arsenal007/TRX/README.md

DIY HF Transceiver
	1) KiCAD PCBs:
		1.1 VFOs
		1.2 MAINBOARDs
		1.3 BPFs
		1.4 AMPs
	2)  VFO firmware
	3) measurements
