arsenal007/TRX/VFOs/UR3ILF_SI5351/cqham/firmware_si5351_28.02.17/README.txt

var1 = mechanical encoder 
var2 = mechanical 4 tact encoder
var3 = optical encoder
