arsenal007/TRX/VFOs/UR3ILF_SI5351/cqham/pcb synt ur3ilf(UPD)/README.RUS.docx

Сделал* две печатные платы синтезатора Андрея UR3ILF.

Спасибо Андрею за хорошую и простую конструкцию!!!

Печатные платы от авторской отличаются следующим:

0. Они универсальны! Хотите утюжьте или Китайчикам на Али заказывайте. Вторая сторона в случаи ЛУТ закрашивается, после травления зенкуется и устанавливаются необходимые перемычки (показаны связями).

1.Размерами. Мои платы чуть больше.

2.Убрал узел на LM358. На мой взгляд, его проще расположить на валкодере, да и в последнее время трудно стало найти мышку шариковую уже))). К синтезатору Вы сможете подключить любую «трещотку» 48 импульсов или оптический энкодер с открытым коллектором ( тогда конденсаторы 4700пф которые "сидят" на общий провод с 1й и 32 ноги atmega 168&328) устанавливать не нужно.

3.Добавил разъем (ISP бокового-углового исполнения) для удобного и быстрого подключения программатора usbasp через шлейф с которым он продается на Ali.

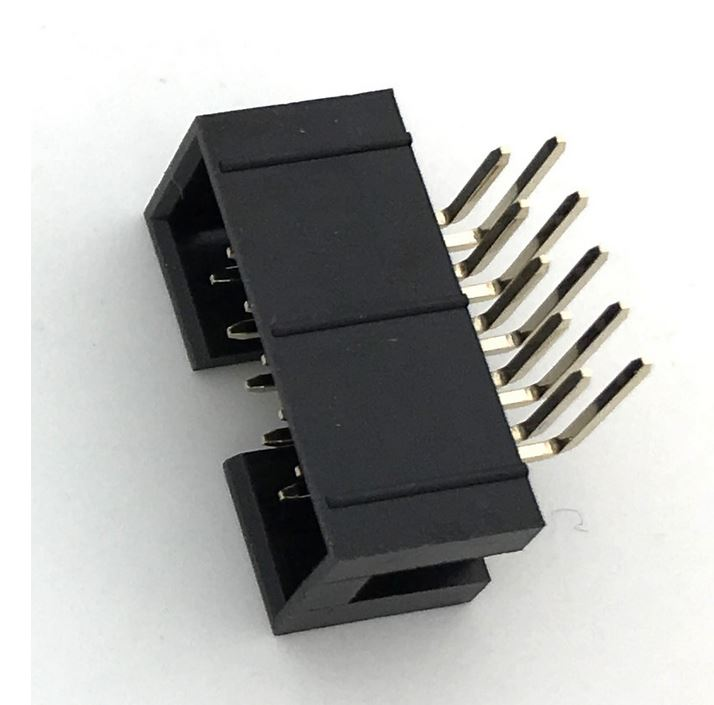
[picture p1: figure]

4. Добавил разъемы типа SMA (углового типа) для всех трех выходов CLK0,1,2 SI5351. Быть может нужен будет CLK2 кому либо.

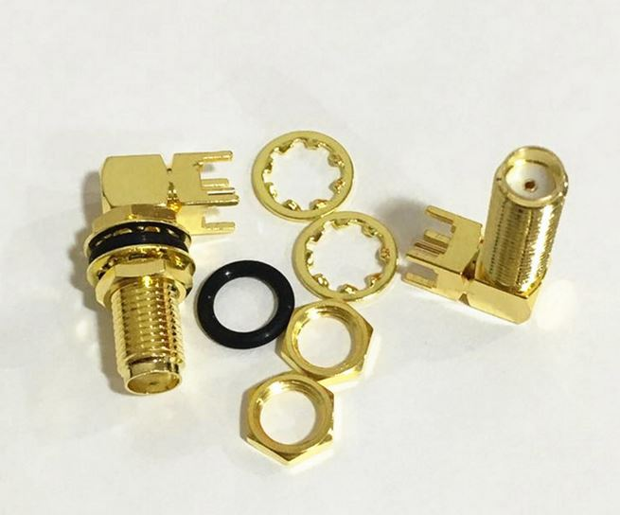
[picture p2: figure]

5. После выходов dds имеются площадки для установки smd индуктивностей и конденсаторов для фильтр пробок.

6. Разводка дисплея сделана под дешевый Китайский вариант с верхним однорядным расположением пинов.

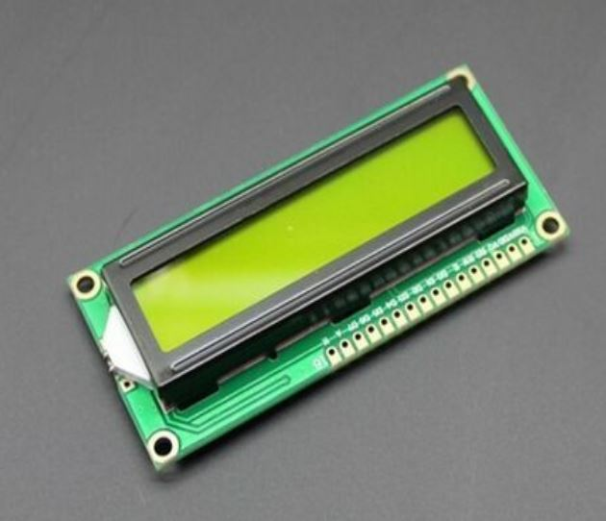
[picture p3: figure]

Детали

Резисторы и конденсаторы изпользуются в разных корпусах это 1206 и 0805.

Упор делался на 1206 так как с ними проще работать имея дрожащие руки и плохое зрение.

Все номиналы подписаны на плате и отображаются когда подводишь курсор к элементу.

В дисплей впаивается 16 штырьковая вилка PLS-16.

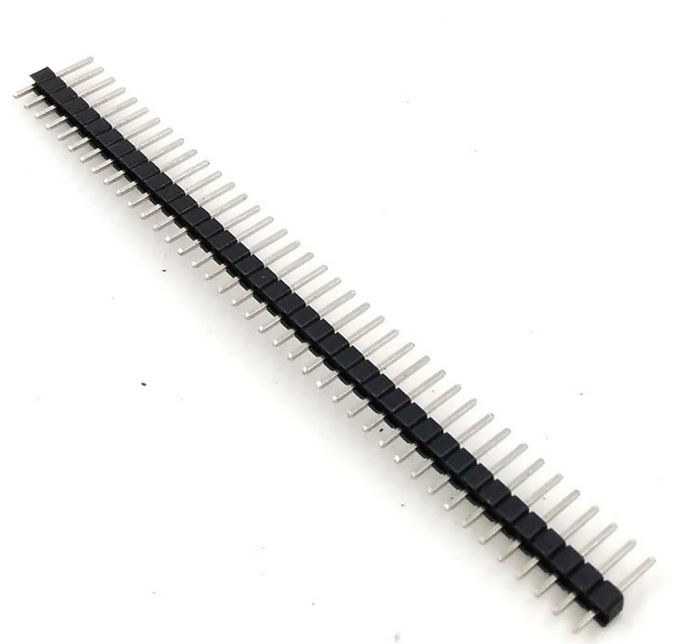
[picture p4: figure]

В плату впаивается для вилки гнездо PBS-16 .

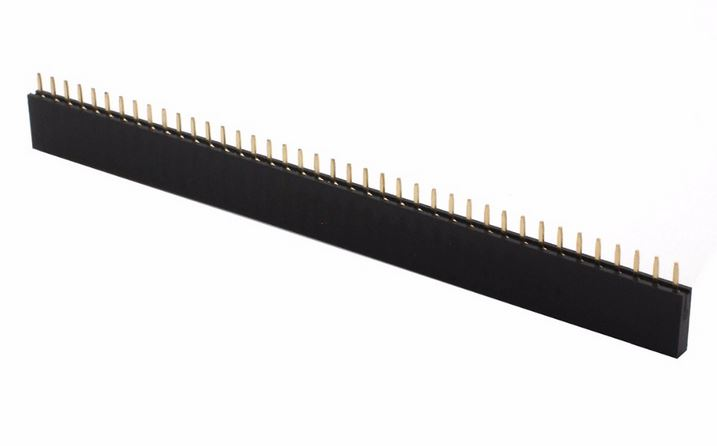
[picture p5: figure]

Дсплей крепится на 4 шт стойки латунные шестигранные, h = 10 мм, резьба под винт М3.

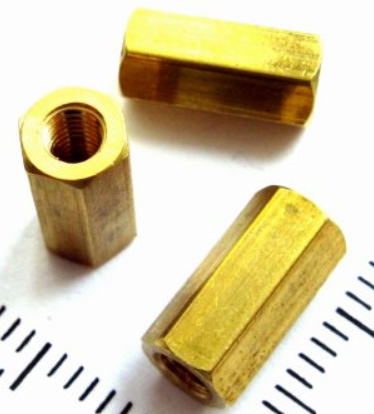
[picture p6: figure]

Разьем питания PLS 2 штырька. Можно сделать из любого разъема.

Все остальные штыревые разъемы углового типа PLS.

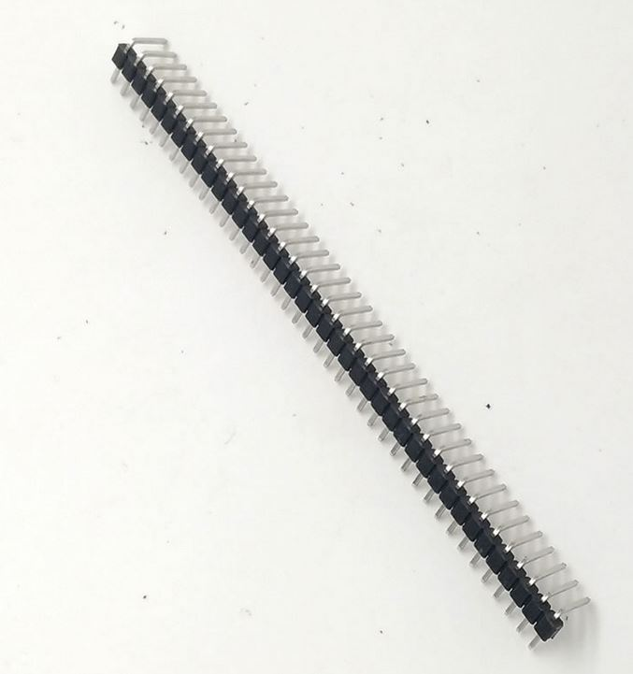
[picture p7: figure]

SMA используюся также углового типа (см рис выше).

В ахиве две печатных платы. Первая для более старшей конструкции ( прошивка пост 722 http://www.cqham.ru/forum/showthread.php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

Версия 2 печатка для конструкции http://ur3ilf.blogspot.ru/ более новой пост 740

http://www.cqham.ru/forum/showthread.php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

*-P.S эти печатки я «в железе» еще не проверял. Пожалуйста перед тем как повторять проверьте!!!
