arsenal007/TRX/MAINBOARDs/QER/QER.GIF

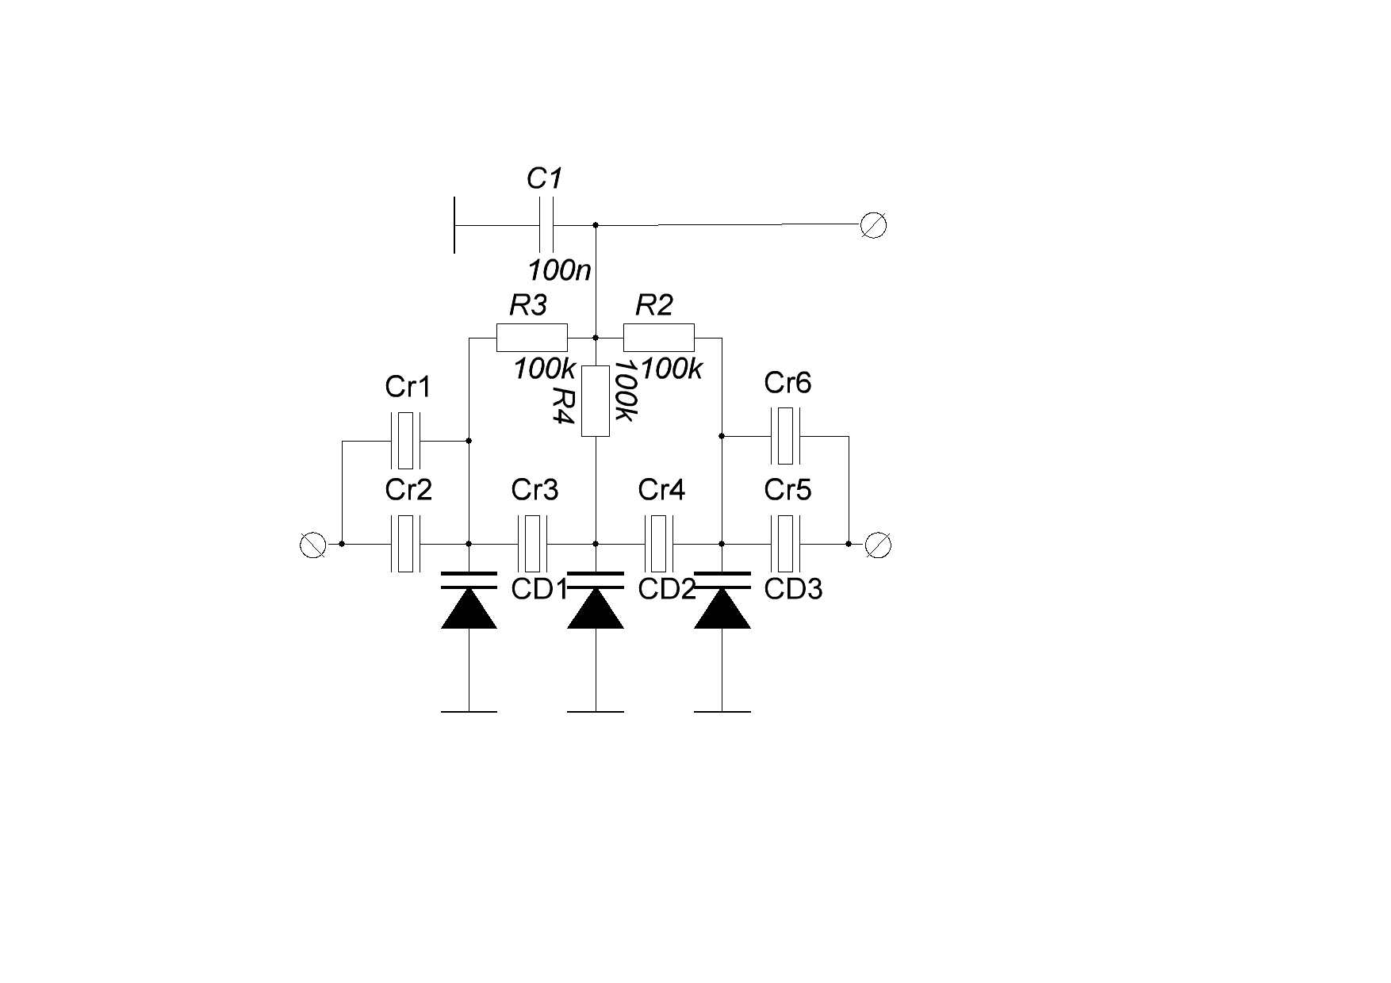
MAINBOARDs/QER/QER.GIF
