arsenal007/TRX/MAINBOARDs/QER/rst-a976.gif

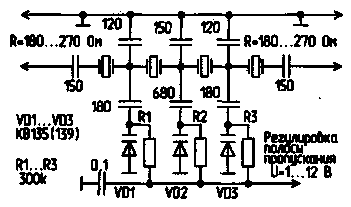
MAINBOARDs/QER/rst-a976.gif
