arsenal007/TRX/VFOs/UT5QBC/HF-EASY2-Schematic.png

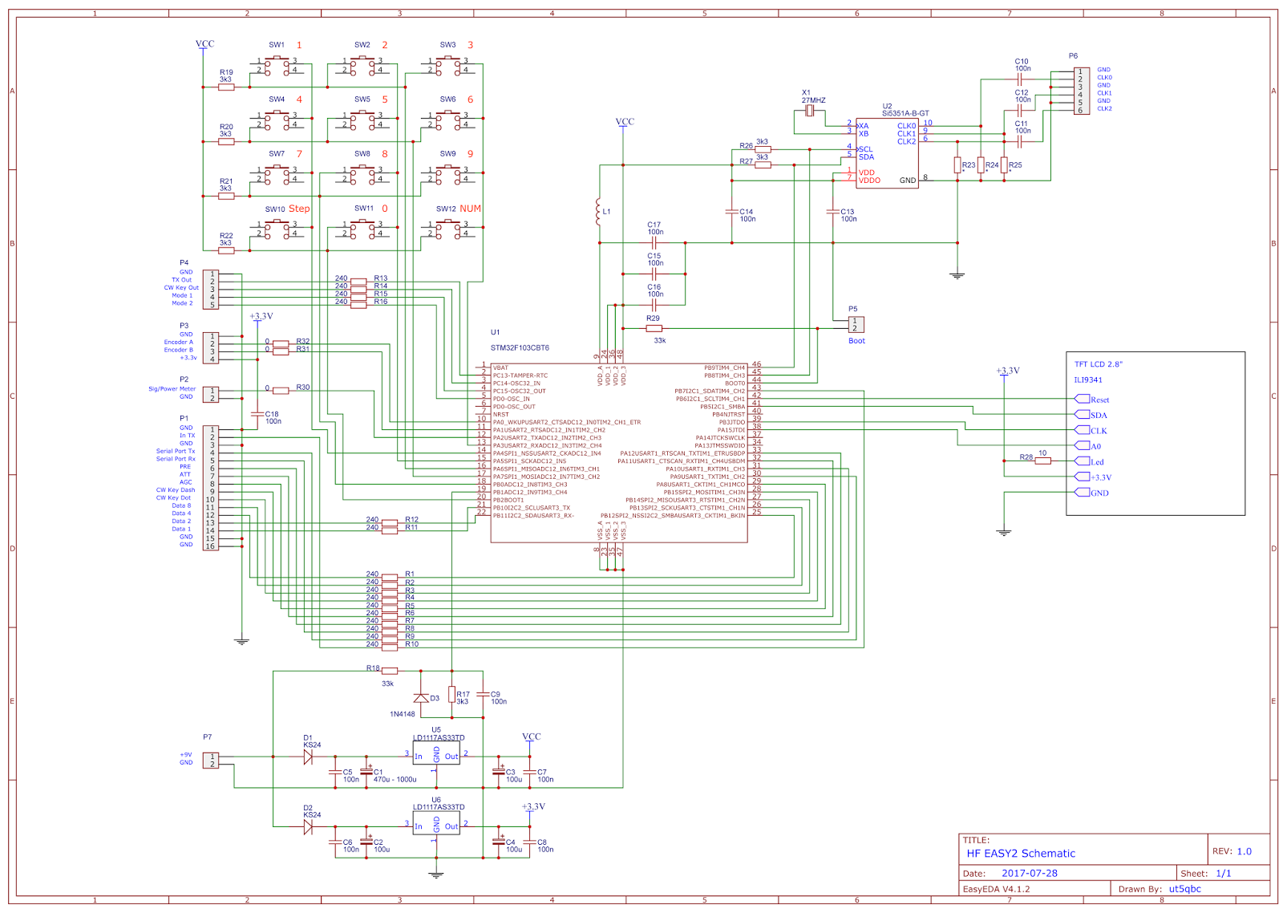
VFOs/UT5QBC/HF-EASY2-Schematic.png
