arsenal007/TRX/VFOs/UR3ILF_SI5351/KiCAD_PCB/UR3ILF.pdf

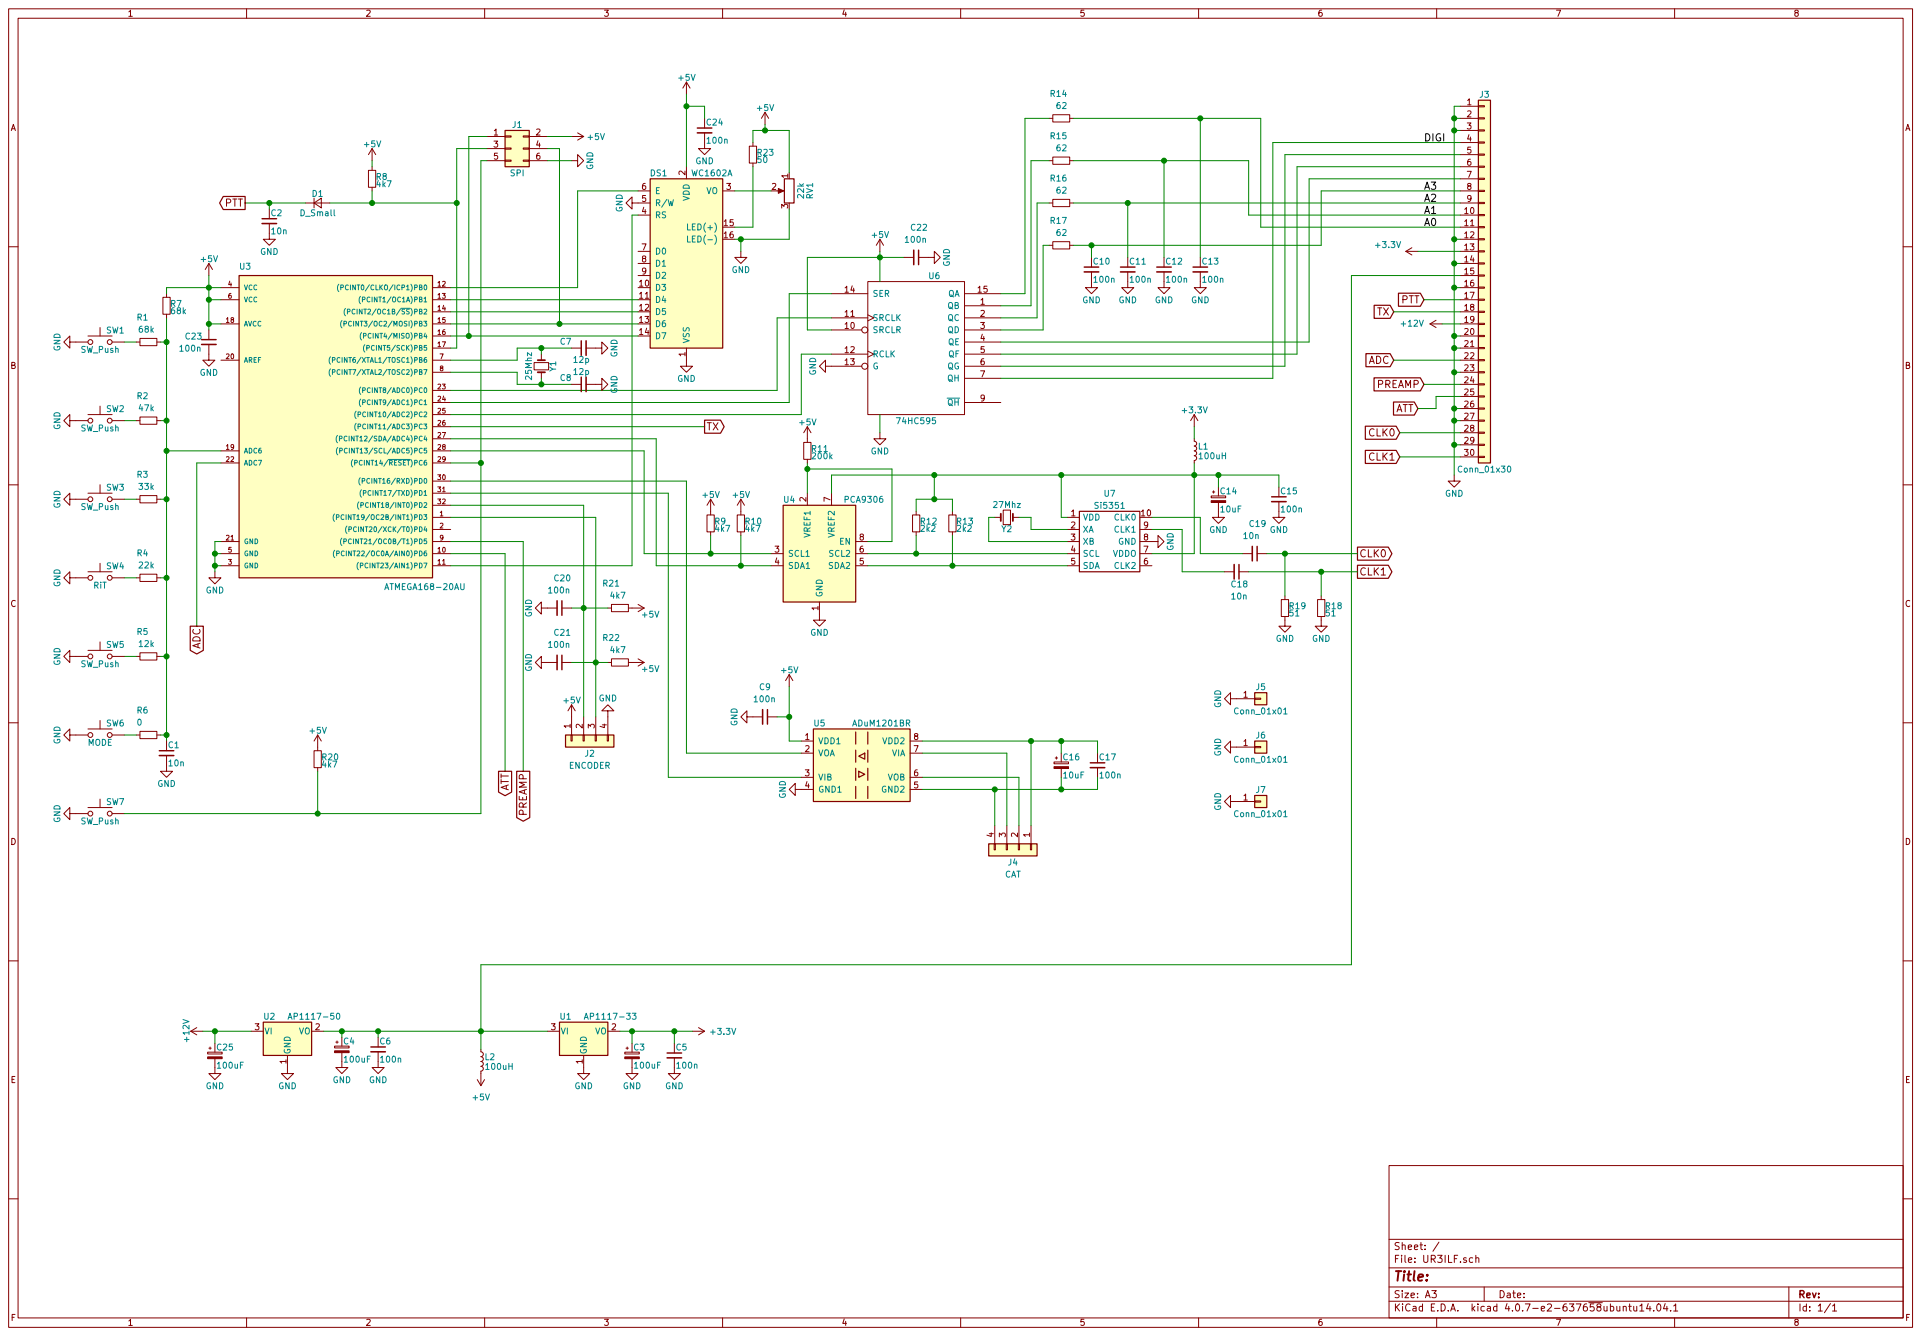
[picture p25: page 1]
