arsenal007/TRX/(list of files, drawings)

Other design files:
VFOs/UR3ILF_SI5351/cqham/pcb synt ur3ilf(UPD)/pcb synt ur3ilf ver1.lay6
VFOs/UR3ILF_SI5351/cqham/pcb synt ur3ilf(UPD)/pcb synt ur3ilf ver2.lay6
VFOs/UR3ILF_SI5351/cqham/schematics_splan/schematics.spl7
