arsenal007/TRX/MAINBOARDs/raisin/Raisin.kicad_pcb

## KiCad design MAINBOARDs/raisin/Raisin.kicad_pcb (2019-11-10)

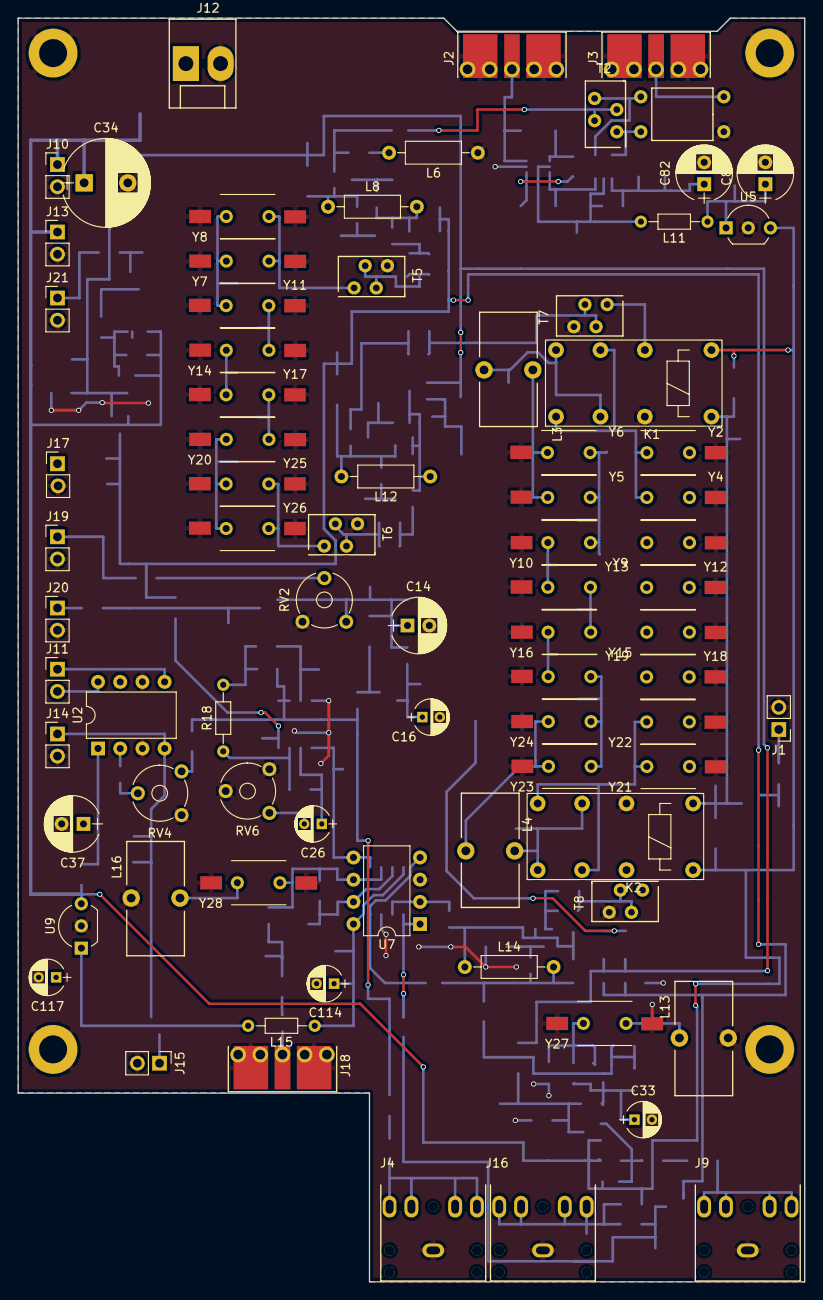
[picture p26: board Raisin.kicad_pcb from above]

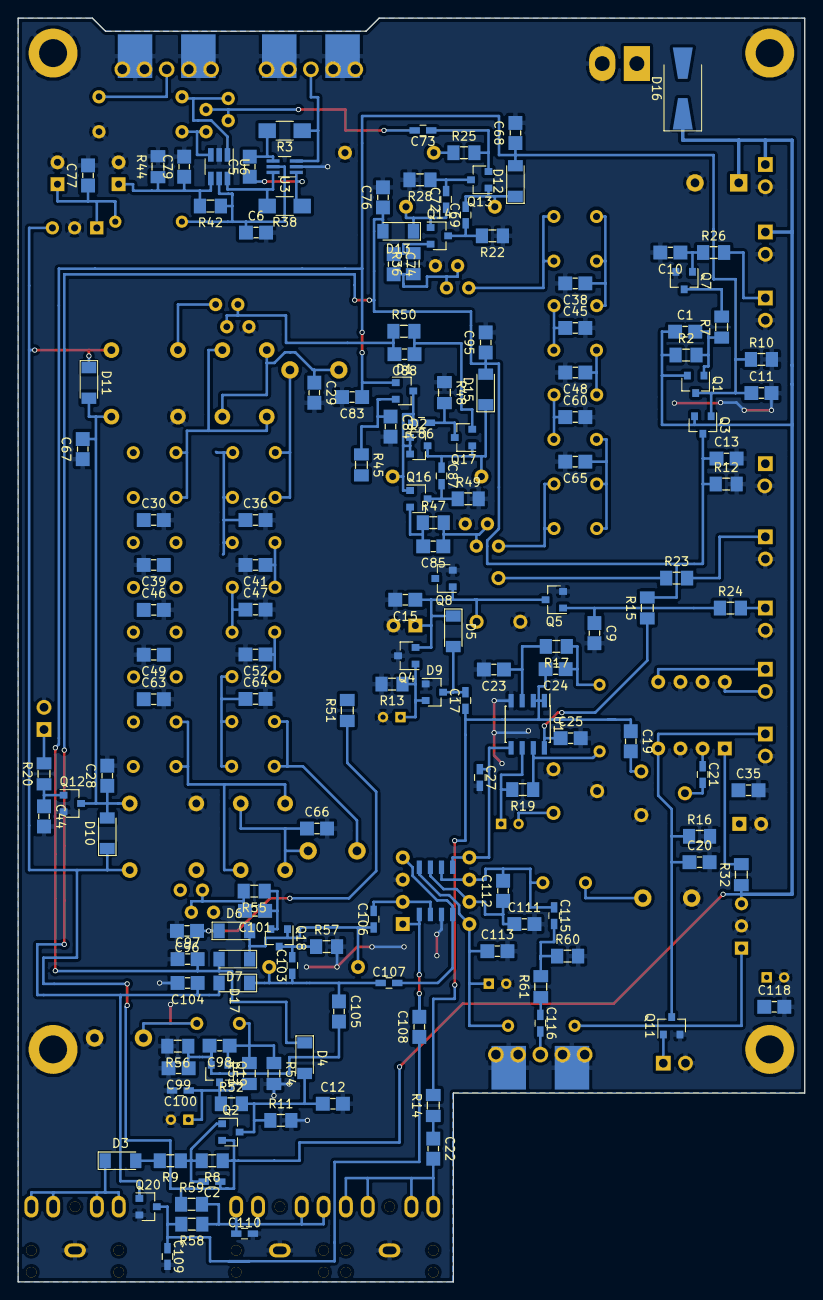
[picture p27: board Raisin.kicad_pcb from below]

Board: 2 copper layers, 90.0 x 144.6 mm, 234 parts (151 on the bottom side), 117 nets.

Parts:
C1, C5, C6, C9, C10, C11, C12, C13, C15, C25, C28, C35, C44, C67, C68, C74, C76, C77, C79, C83, C84, C85, C88, C95, C96, C97, C101, C104, C108, C113, C118: 100nF; C_1206_0603
C2, C17, C21, C100: 100nF; C_0603_HandSoldering
C14: 33uF; CP_Radial_D6.3mm_P2.50mm
C16: 1uF; CP_Radial_D4.0mm_P2.00mm
C19, C20, C22: 1uF; C_1206_0603
C23: 4n7; C_1206_0603
C24: 47n; C_1206_0603
C26, C33, C114, C117: 10uF; CP_Radial_D4.0mm_P2.00mm
C27, C69, C72, C73, C86, C87, C103, C106, C107, C109, C110, C115, C116: 10nF; C_0603_HandSoldering
C29, C30, C36, C38, C39, C41, C45, C46, C47, C48, C49, C52, C60, C63, C64, C65, C66: 100pF*; C_1206_0603
C34: 330uF; CP_Radial_D10.0mm_P5.00mm
C37: 220uF; CP_Radial_D6.3mm_P2.50mm
C80, C82: 22uF; CP_Radial_D6.3mm_P2.50mm
C98: 100pF; C_1206_0603
C99: 180pF; C_1206_0603
C105: 10pF*; C_1206_0603
C111: 22pF*/100nF; C_1206_0603
C112: 22pF; C_1206_0603
D1, D2, D9: BAV99; SOT-23
D3, D4, D5, D6, D7, D12, D13, D15, D17: LL4148; D_MiniMELF
D10, D11: D; D_MiniMELF
D16: SS14; D_SMA-SMB_Universal_Handsoldering
J1: CW; Pin_Header_Straight_1x02_Pitch2.54mm
J2, J3, J18: Conn_Coaxial; RFCONNECTOR
J4: Line OUT; audio_jack_3_5mm_PJ307
J5, J6, J7, J8: Conn_01x01; MountingHole_3.2mm_M3_DIN965_Pad
J9: Key; audio_jack_3_5mm_PJ307
J10: ATT; Pin_Header_Straight_1x02_Pitch2.54mm
J11: Speaker; Pin_Header_Straight_1x02_Pitch2.54mm
J12: POWER; Molex_KK-41791-02_02x3.96mm_Straight
J13, J17: BPF; Pin_Header_Straight_1x02_Pitch2.54mm
J14: AMP; Pin_Header_Straight_1x02_Pitch2.54mm
J15: TX; Pin_Header_Straight_1x02_Pitch2.54mm
J16: MIC; audio_jack_3_5mm_PJ307
J19: S-metr; Pin_Header_Straight_1x02_Pitch2.54mm
J20: AGC_OFF; Pin_Header_Straight_1x02_Pitch2.54mm
J21: TX_SYNT; Pin_Header_Straight_1x02_Pitch2.54mm
K1, K2: RS-12
L3, L4: L; Choke_Toroid_6,5x13mm_Vertical
L6, L8, L12, L14: 22uH; R_Axial_DIN0207_L6.3mm_D2.5mm_P10.16mm_Horizontal
L11, L15: 47uH; R_Axial_DIN0204_L3.6mm_D1.6mm_P7.62mm_Horizontal
L13, L16: L_Small; Choke_Toroid_6,5x13mm_Vertical
Q1, Q2, Q3: Si2301-TP; SOT-23
Q4: MMBT3906; SOT-23
Q5, Q7, Q8, Q11: 2N7002; SOT-23
Q12: MMBT2222; SOT-23
Q13, Q14, Q16, Q17, Q18: MMBFJ310LT1G; SOT-23
Q19: MMBT2222LT1G; SOT-23
Q20: BSS138; SOT-23
R2, R7, R8, R9: 2.7k; R_1206_0603
R3, R38: 1M; R_1206_HandSoldering
R10, R11, R12, R45: 4.7k; R_1206_0603
R13, R16: 150k*; R_1206_0603
R14, R15: 100; R_1206_0603
R17, R19, R59: 15k; R_1206_0603
R18: 1k; R_Axial_DIN0204_L3.6mm_D1.6mm_P7.62mm_Horizontal
R20: 2k; R_1206_0603
R22, R28: 220; R_1206_0603
R23: 12k; R_1206_0603
R24, R26: 2.2k; R_1206_0603
R25, R36, R47, R50, R55: 30; R_1206_0603
R32: 0*; R_1206_0603
R42, R44: 3,3k; R_1206_0603
R48, R49: 1.5k*; R_1206_0603
R51, R58, R60, R61: 1k; R_1206_0603
R52: 100R; R_1206_0603
R53: 100k; R_1206_0603
R54: 200k; R_1206_0603
R56: 750*; R_1206_0603
R57: 10k; R_1206_0603
RV2: 1M; Potentiometer_Trimmer_Piher_PT-6v_Horizontal
RV4: 33k; Potentiometer_Trimmer_Piher_PT-6v_Horizontal
RV6: 1k; Potentiometer_Trimmer_Piher_PT-6v_Horizontal
T1: 1:2; TF_2
T2, T5, T6, T7, T8: Transformer; TF14
U1: NE5532; SOIC-8_3.9x4.9mm_Pitch1.27mm
U2: TDA7052A; DIP-8_W7.62mm
U3: NC7WZ04; SOT-363_SC-70-6_Handsoldering
U5: L78L05_TO92; TO-92_Inline_Wide
U6: FSA3157L6X; SOT-23-6_Handsoldering
U7: SA612A; DIP-8_SOIC-8_W7.62mm
U9: L78L06_TO92; TO-92_Inline_Wide
Y2, Y4, Y10, Y12, Y16, Y18, Y23, Y24: Crystal_GND23_Small; Crystal_HC49-U_Vertical_3GND
Y5, Y6, Y9, Y13, Y15, Y19, Y21, Y22: Crystal_GND23_Small; Crystal_HC49-U_Vertical_4GND
Y7, Y8, Y11, Y14, Y17, Y20, Y25, Y26, Y27, Y28: Crystal_GND23_Small; Crystal_HC49-U_Vertical

Connections:
+12V: C1.1, C2.1, C34.1, D10.1, D11.1, D16.1, J10.1, J13.1, J17.1, K1.9, K2.8, Q1.2, Q2.2, Q3.2, R2.1, R8.1, R32.1, R59.1, U5.3, U9.3
AGC: Q8.3, R45.2, R51.2
AGC_OFF: J20.1, R24.2
AUDIO: C27.1, U1.5, U7.5
BFO: C116.2, J18.1
BPF: J3.1, T1.1
CW: J1.1, R20.2
CW_TONE: C12.1, D4.2, Q2.3, R11.1, R52.2
GND: C6.2, C9.2, C10.2, C11.2, C12.2, C13.2, C14.2, C15.2, C16.2, C20.2, C23.2, C25.2, C27.2, C28.2, C29.2, C30.2, C33.2, C34.2, C35.2, C36.2, C37.2, C38.2, C39.2, C41.2, C44.2, C45.2, C46.2, C47.2, C48.2, C49.2, C52.2, C60.2, C63.2, C64.2, C65.2, C66.2, C67.1, C68.2, C76.2, C77.2, C79.2, C80.2, C82.2, C83.2, C84.2, C95.2, C96.2, C97.1, C99.2, C100.2, C104.2, C109.2, C110.2, C111.2, C113.2, C114.2, C117.2, C118.2, D9.1, J1.2, J2.2, J3.2, J4.3, J5.1, J6.1, J7.1, J8.1, J9.3, J10.2, J12.2, J13.2, J14.2, J15.2, J16.3, J17.2, J18.2, J19.2, J20.2, J21.2, K1.5, K2.12, L6.1, L13.1, L16.2, Q4.3, Q5.2, Q7.2, Q8.2, Q11.2, Q12.2, Q20.2, R10.2, R11.2, R12.2, R13.2, R16.2, R22.1, R28.2, R44.2, R48.1, R49.2, R54.2, R56.2, R57.2, R60.2, RV2.3, RV4.3, RV6.1, RV6.2, T1.2, T5.4, T6.4, T7.4, T8.4, U1.4, U2.3, U2.6, U3.2, U5.2, U6.2, U7.3, U9.2, Y2.3, Y4.3, Y5.4, Y6.4, Y7.3, Y7.4, Y8.3, Y8.4, Y9.4, Y10.3, Y11.3, Y11.4, Y12.3, Y13.4, Y14.3, Y14.4, Y15.4, Y16.3, Y17.3, Y17.4, Y18.3, Y19.4, Y20.3, Y20.4, Y21.4, Y22.4, Y23.3, Y24.3, Y25.3, Y25.4, Y26.3, Y26.4, Y27.3, Y27.4, Y28.3, Y28.4
unnamed: C1.2, Q1.1, R2.2, R7.1
unnamed: C2.2, Q2.1, R8.2, R9.1
unnamed: C5.1, R38.1, U3.1
unnamed: C5.2, R3.2, U3.4
unnamed: C9.1, Q5.1, R24.1
unnamed: C10.1, Q7.1, R26.1
unnamed: C14.1, C15.1, D5.1, Q4.2, Q5.3, Q8.1, RV2.1
unnamed: C16.1, D9.2, Q4.1, R13.1
unnamed: C17.1, C19.1, C24.2, R14.2, U1.1, U1.2
unnamed: C17.2, D5.2, D9.3
unnamed: C19.2, RV4.1
unnamed: C20.1, J14.1, Q11.3, R16.1, U2.4
unnamed: C21.1, U2.2
unnamed: C21.2, RV4.2
unnamed: C22.1, R14.1
unnamed: C22.2, J4.1, J4.2, J4.4, J4.5
unnamed: C23.1, R17.2, U1.3
unnamed: C24.1, R17.1, R18.2
unnamed: C25.1, R15.1, U1.8
unnamed: C26.1, R19.2, U1.6
unnamed: C26.2, RV6.3
unnamed: C28.1, C67.2, D10.2, D11.2, K1.8, K2.9, Q12.3
unnamed: C29.1, K1.3, K1.16, L3.1
unnamed: C30.1, Y2.2, Y4.2, Y9.1
unnamed: C35.1, C37.1, R32.2, U2.1
unnamed: C36.1, Y5.2, Y6.2, Y10.1
unnamed: C38.1, Y7.2, Y8.2, Y11.1
unnamed: C39.1, Y9.2, Y12.1
unnamed: C41.1, Y10.2, Y13.1
unnamed: C44.1, Q12.1, R20.1
unnamed: C45.1, Y11.2, Y14.1
unnamed: C46.1, Y12.2, Y15.1
unnamed: C47.1, Y13.2, Y16.1
unnamed: C48.1, Y14.2, Y17.1
unnamed: C49.1, Y15.2, Y18.1
unnamed: C52.1, Y16.2, Y19.1
unnamed: C60.1, Y17.2, Y20.1
unnamed: C63.1, Y18.2, Y21.1, Y22.1
unnamed: C64.1, Y19.2, Y23.1, Y24.1
unnamed: C65.1, Y20.2, Y25.1, Y26.1
unnamed: C66.1, K2.1, K2.14, L4.2
unnamed: C69.1, Q14.3, R22.2
unnamed: C69.2, D12.1, L8.1, Q13.1
unnamed: C72.1, D13.1, L8.2, Q14.1
unnamed: C72.2, Q13.3, R28.1
unnamed: C73.1, Q13.2, R25.2
unnamed: C73.2, T2.2, T2.3
unnamed: C74.1, Q14.2, R36.2
unnamed: C74.2, R36.1, T5.2, T5.3
unnamed: C77.1, C80.1, L11.1, U5.1
unnamed: C79.1, C82.1, R42.2, R44.1, U6.4
unnamed: C84.1, D1.2, R45.1
unnamed: C85.1, R47.2, T6.2, T6.3
unnamed: C85.2, Q16.2, R47.1
unnamed: C86.1, Q17.3, R48.2
unnamed: C86.2, D1.3, D2.1, D2.2, L12.1, Q16.1
unnamed: C87.1, D2.3, D15.1, L12.2, Q17.1
unnamed: C87.2, Q16.3, R49.1
unnamed: C88.1, Q17.2, R50.2
unnamed: C88.2, R50.1, T7.2, T7.3
unnamed: C96.1, D6.1, R51.1
unnamed: C98.1, Q19.1, R53.2, R54.1, Y27.2
unnamed: C33.1, C100.1, Q19.3, R52.1, R53.1
unnamed: C101.1, Q18.2, R55.1
unnamed: C101.2, R55.2, T8.2, T8.3
unnamed: C103.1, C105.1, C107.1, D17.1, L14.2
unnamed: C103.2, Q18.3, R57.1
unnamed: C98.2, C99.1, C105.2, Q19.2, R56.1
unnamed: C106.1, D6.2, D7.1, L14.1, Q18.1
unnamed: C106.2, U7.2
unnamed: C107.2, U7.4
unnamed: C108.1, C109.1, Q20.3, R58.2
unnamed: C108.2, U7.1
unnamed: C110.1, J16.1, J16.2, J16.4, J16.5, R58.1, R59.2
unnamed: C111.1, C112.1, U7.7
unnamed: C112.2, C115.1, U7.6, Y28.1
unnamed: C113.1, C114.1, L15.1, U7.8
unnamed: C115.2, R60.1, R61.2
unnamed: C116.1, R61.1
unnamed: C117.1, C118.1, L15.2, U9.1
unnamed: D3.1, J9.1, J9.2, J9.4, J9.5
unnamed: D3.2, R9.2
unnamed: D16.2, J12.1
unnamed: J11.1, U2.5
unnamed: J11.2, U2.8
unnamed: J19.1, R23.2
unnamed: K1.1, K1.14, Y2.1, Y4.1
unnamed: K2.3, K2.16, Y21.2, Y22.2
unnamed: L3.2, Y5.1, Y6.1
unnamed: L4.1, Y23.2, Y24.2
unnamed: L6.2, R25.1
unnamed: L13.2, Y27.1
unnamed: L16.1, Y28.2
unnamed: Q7.3, R7.2
unnamed: R18.1, R19.1, U1.7
unnamed: R38.2, U3.6, U6.6
unnamed: T1.3, T2.4, U6.1
unnamed: T1.4, T2.1, U6.3
QER11: T5.1, Y7.1, Y8.1
QER12: T6.1, Y25.2, Y26.2
QER21: K1.12, T7.1
QER22: K2.5, T8.1
RX: C13.1, C76.1, C95.1, C104.1, D13.2, D15.2, D17.2, Q3.3, Q20.1, R12.1, R15.2
S-metr: R23.1, RV2.2
TX: C11.1, C68.1, C83.1, C97.2, D1.1, D4.1, D7.2, D12.2, J15.1, Q1.3, Q3.1, Q11.1, R10.1
TX_SYNT: J21.1, R26.2
VCC: C6.1, L11.2, R42.1, U3.5, U6.5
VFO: J2.1, R3.1, U3.3
