arsenal007/TRX/VFOs/UR3ILF_SI5351/KiCAD_PCB/UR3ILF.kicad_pcb

## KiCad design VFOs/UR3ILF_SI5351/KiCAD_PCB/UR3ILF.kicad_pcb (2019-09-23)

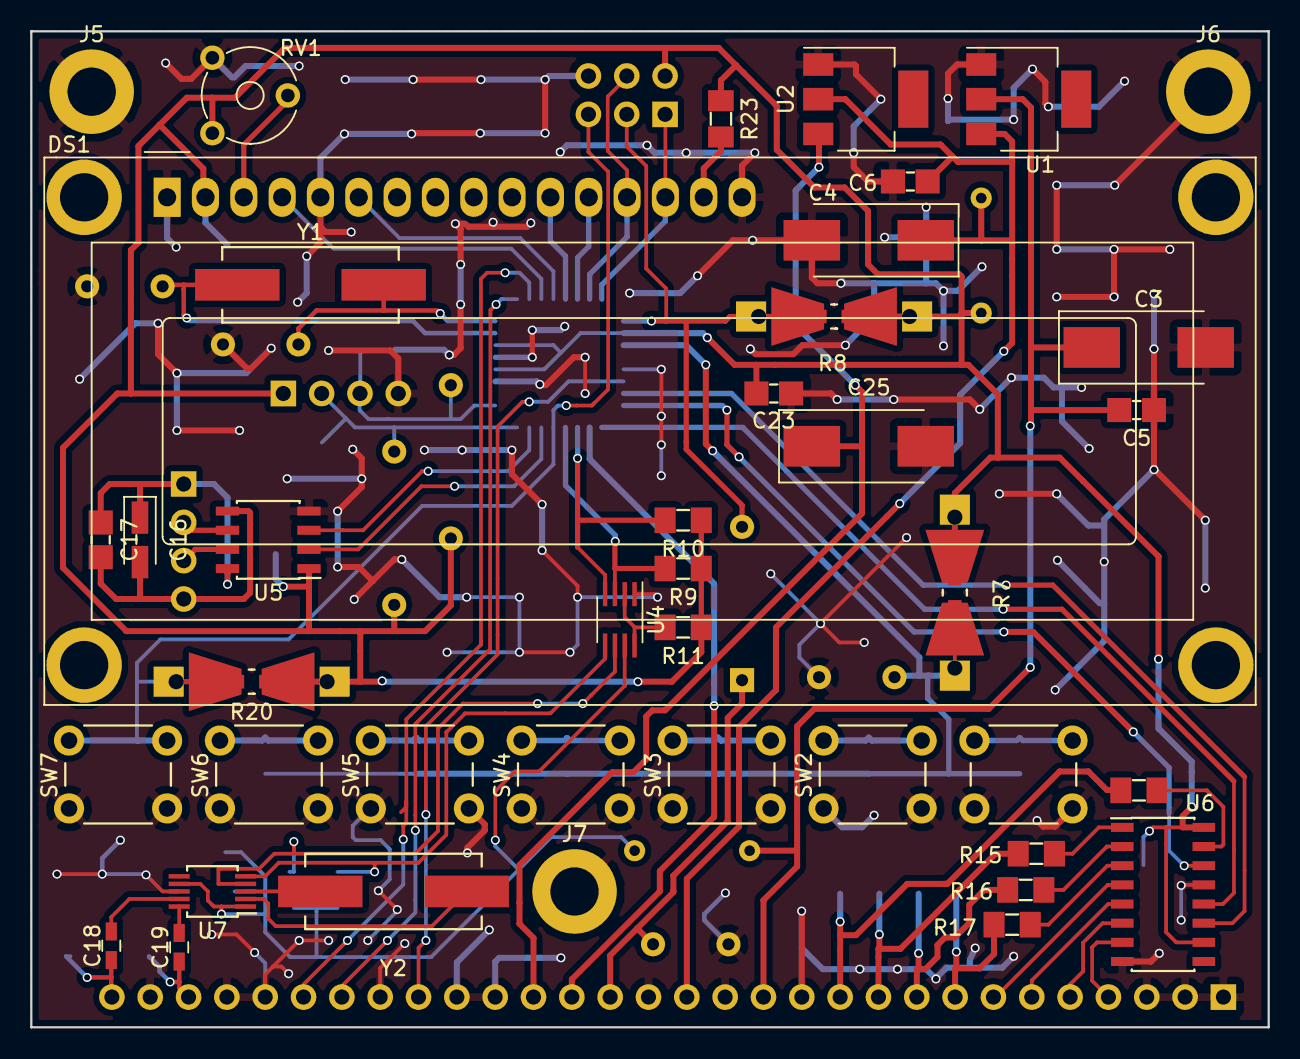
[picture p28: board UR3ILF.kicad_pcb from above]

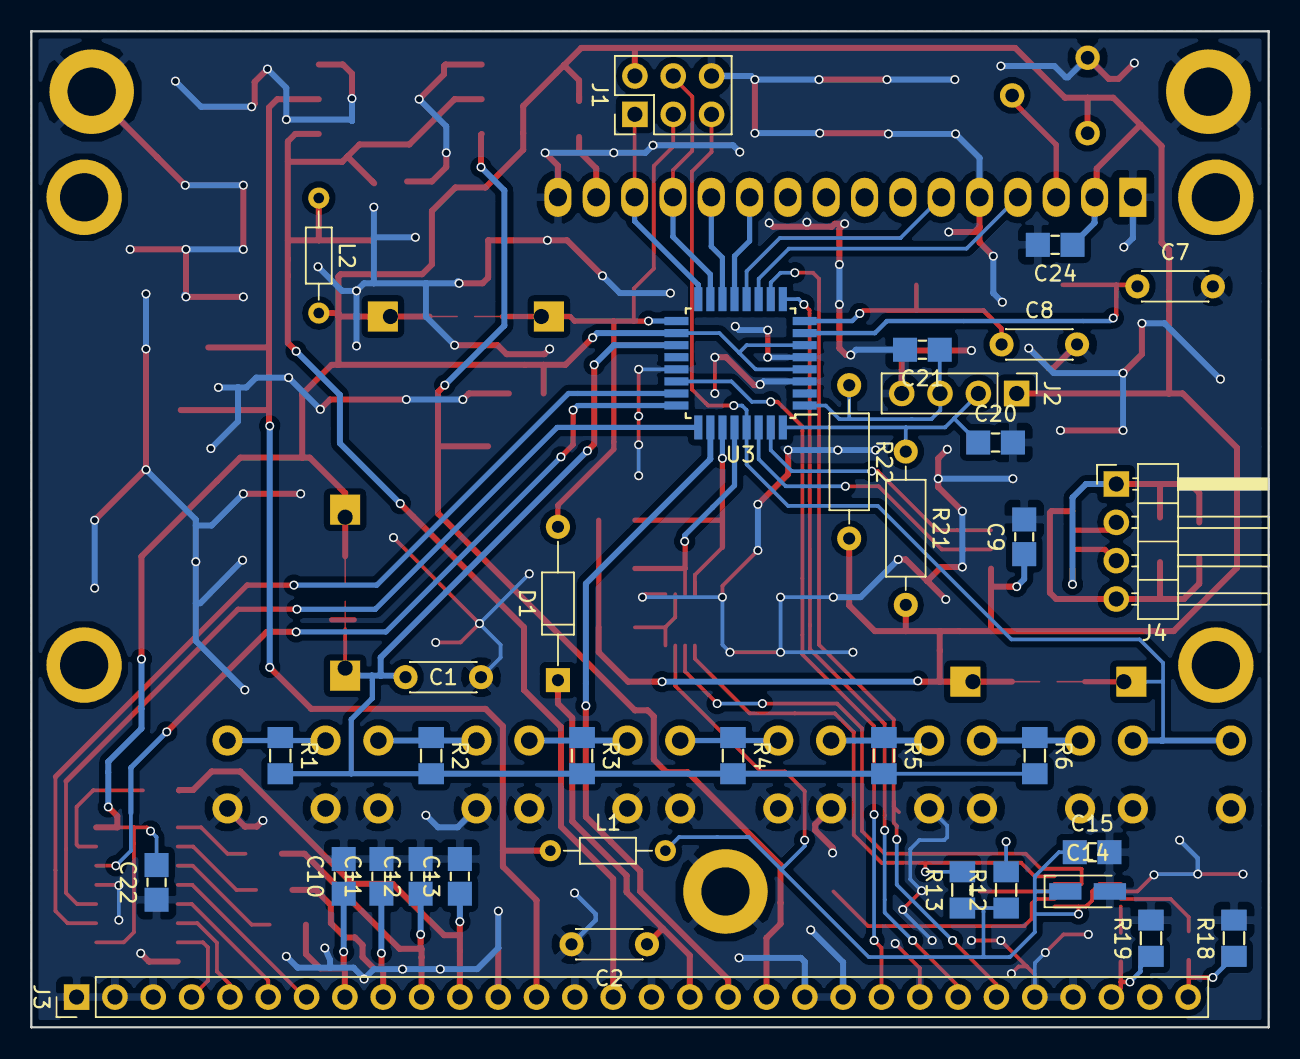
[picture p29: board UR3ILF.kicad_pcb from below]

Board: 2 copper layers, 82.0 x 66.0 mm, 76 parts (35 on the bottom side), 64 nets.

Parts:
C1, C2: 10n; C_Disc_D4.3mm_W1.9mm_P5.00mm
C3, C4, C25: 100uF; CP_Tantalum_Case-D_EIA-7343-31_Hand
C5, C6, C9, C10, C11, C12, C13, C15, C17, C20, C21, C22, C23, C24: 100n; C_1206_0603
C7, C8: 12p; C_Disc_D4.3mm_W1.9mm_P5.00mm
C14, C16: 10uF; CP_Tantalum_Case-A_EIA-3216-18_Wave
C18, C19: 10n; C_0603_HandSoldering
D1: D_Small; D_DO-35_SOD27_P10.16mm_Horizontal
DS1: WC1602A
J1: SPI; Pin_Header_Straight_2x03_Pitch2.54mm
J2: ENCODER; Pin_Header_Straight_1x04_Pitch2.54mm
J3: Conn_01x30; Pin_Header_Straight_1x30_Pitch2.54mm
J4: CAT; Pin_Header_Angled_1x04_Pitch2.54mm
J5, J6, J7: Conn_01x01; MountingHole_3.2mm_M3_DIN965_Pad
L1, L2: 100uH; R_Axial_DIN0204_L3.6mm_D1.6mm_P7.62mm_Horizontal
R1: 68k; R_1206_0603
R2: 47k; R_1206_0603
R3: 33k; R_1206_0603
R4: 22k; R_1206_0603
R5: 12k; R_1206_0603
R6: 0; R_1206_0603
R7: 68k; Resistor_SMD+THTuniversal_0603to2512_RM10_HandSoldering
R8, R20: 4k7; Resistor_SMD+THTuniversal_0603to2512_RM10_HandSoldering
R9, R10: 4k7; R_1206_0603
R11: 200k; R_1206_0603
R12, R13: 2k2; R_1206_0603
R14, R15, R16, R17: 62; R_1206_0603
R18, R19: 51; R_1206_0603
R21, R22: 4k7; R_Axial_DIN0207_L6.3mm_D2.5mm_P10.16mm_Horizontal
R23: 50; R_1206_0603
RV1: 22k; Potentiometer_Trimmer_Piher_PT-6v_Horizontal
SW1, SW2, SW3, SW5, SW7: SW_Push; SW_PUSH_6mm_h13mm
SW4: RiT; SW_PUSH_6mm_h13mm
SW6: MODE; SW_PUSH_6mm_h13mm
U1: AP1117-33; SOT-223
U2: AP1117-50; SOT-223
U3: ATMEGA168-20AU; TQFP-32_7x7mm_Pitch0.8mm
U4: PCA9306; SSOP-8_2.95x2.8mm_Pitch0.65mm
U5: ADuM1201BR; SOIC-8_3.9x4.9mm_Pitch1.27mm
U6: 74HC595; SOIC-16_3.9x9.9mm_Pitch1.27mm
U7: Si5351; MSOP-10_3x3mm_Pitch0.5mm
Y1: 25Mhz; Crystal_HC49-SD_SMD
Y2: 27Mhz; Crystal_HC49-SD_SMD

Connections:
+3V3: C3.1, C5.1, J3.13, L1.1, U1.2
+5V: C9.1, C22.2, C23.1, C24.1, DS1.2, J1.2, J2.1, L2.2, R7.1, R8.1, R9.1, R10.1, R11.1, R20.1, R21.2, R22.2, R23.1, RV1.1, U3.4, U3.6, U3.18, U5.1, U6.10, U6.16
+12V: C25.1, J3.19, U2.3
ADC: J3.22, U3.22
ATT: J3.25, U3.10
CLK0: C19.1, J3.28, R19.1
CLK1: C18.1, J3.30, R18.1
GND: C1.2, C2.2, C3.2, C4.2, C5.2, C6.2, C7.2, C8.2, C9.2, C10.2, C11.2, C12.2, C13.2, C14.2, C15.2, C20.2, C21.2, C22.1, C23.2, C24.2, C25.2, DS1.1, DS1.5, DS1.16, J1.6, J2.4, J3.1, J3.2, J3.3, J3.12, J3.14, J3.16, J3.20, J3.21, J3.23, J3.26, J3.27, J3.29, J5.1, J6.1, J7.1, R18.2, R19.2, RV1.3, SW1.1, SW2.1, SW3.1, SW4.1, SW5.1, SW6.1, SW7.1, U1.1, U2.1, U3.3, U3.5, U3.21, U4.1, U5.4, U6.8, U6.13, U7.8
unnamed: C1.1, R1.2, R2.2, R3.2, R4.2, R5.2, R6.2, R7.2, U3.19
unnamed: C4.1, C6.1, J3.15, L2.1, U1.3, U2.2
unnamed: C7.1, U3.7, Y1.1
unnamed: C8.1, U3.8, Y1.2
unnamed: C10.1, J3.8, R17.2
unnamed: C11.1, J3.9, R16.2
unnamed: C12.1, J3.10, R15.2
unnamed: C13.1, J3.11, R14.2
unnamed: C14.1, C15.1, L1.2, R12.1, R13.1, U4.7, U7.1, U7.7
unnamed: C16.1, C17.1, J4.1, U5.8
unnamed: C16.2, C17.2, J4.4, U5.5
unnamed: C18.2, U7.9
unnamed: C19.2, U7.10
unnamed: C20.1, J2.2, R21.1, U3.32
unnamed: C21.1, J2.3, R22.1, U3.1
unnamed: D1.2, J1.3, R8.2, U3.17
unnamed: DS1.3, RV1.2
unnamed: DS1.4, U3.11
unnamed: DS1.6, U3.12
unnamed: DS1.11, U3.13
unnamed: DS1.12, U3.14
unnamed: DS1.13, J1.4, U3.15
unnamed: DS1.14, J1.1, U3.16
unnamed: DS1.15, R23.2
unnamed: J1.5, R20.2, SW7.2, U3.29
unnamed: J3.4, U6.7
unnamed: J3.5, U6.6
unnamed: J3.6, U6.5
unnamed: J3.7, U6.4
unnamed: J4.2, U5.6
unnamed: J4.3, U5.7
unnamed: R1.1, SW1.2
unnamed: R2.1, SW2.2
unnamed: R3.1, SW3.2
unnamed: R4.1, SW4.2
unnamed: R5.1, SW5.2
unnamed: R6.1, SW6.2
unnamed: R9.2, U3.28, U4.3
unnamed: R10.2, U3.27, U4.4
unnamed: R11.2, U4.2, U4.8
unnamed: R12.2, U4.6, U7.4
unnamed: R13.2, U4.5, U7.5
unnamed: R14.1, U6.15
unnamed: R15.1, U6.1
unnamed: R16.1, U6.2
unnamed: R17.1, U6.3
unnamed: U3.23, U6.11
unnamed: U3.24, U6.14
unnamed: U3.25, U6.12
unnamed: U3.30, U5.2
unnamed: U3.31, U5.3
unnamed: U7.2, Y2.1
unnamed: U7.3, Y2.2
PREAMP: J3.24, U3.9
PTT: C2.1, D1.1, J3.17
TX: J3.18, U3.26
