arsenal007/TRX/(commit log)

2019-06-15 bad pcb layout
    [Raisin.kicad_pcb, Raisin.sch]
2019-07-21 PCB to 0603, Buzzer
    [Raisin.kicad_pcb, Raisin.sch]
2019-08-13 Add GND connection points
    [Raisin.kicad_pcb, Raisin.sch]
2019-09-23 add VFO, UR3ILF, Si5351a
    [UR3ILF-B.Cu.gbl, UR3ILF-B.Cu.gbr, UR3ILF-B.Mask.gbr, UR3ILF-B.Mask.gbs, UR3ILF-Edge.Cuts.gbr, UR3ILF-Edge.Cuts.gm1, UR3ILF-F.Cu.gbr, UR3ILF-F.Cu.gtl]
2019-09-23 move MAINBOARDs, ordering
    [Raisin.kicad_pcb, Raisin.sch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]
2019-11-06 PCB almost ready
    [FILTERS.sch, Input_mixer.sch, RX_TX_CW.sch, Raisin.kicad_pcb, Raisin.sch, UR3ILF.sch, sa612.sch]
2019-11-10 DX PCB
    [RX_TX_CW.sch, Raisin.kicad_pcb]
